Tympan/Tympan_Rev_D_Hardware/README.md

# Tympan Rev D Hardware
Repository for Tympan Rev D electronics and case designs

## Features

* Based on Teensy 3.6
* TLV320AIC3206 CODEC
* On board MEMS Microphone SPM0687LR5H-1
* BC127 Bluetooth module with audio support
* LiPo Battery Charge Circuit
* CODEC Line In/Out breakout
* UART breakout
* I2C breakout
* SPI breakout
* I2S breakout
* Teensy RTC battery breakout

### Tympan Rev D breakout pins compatible with Tympan AIC Codec Shield. Add 2 more channels to your Tympan!
