Tympan/Tympan_Rev_D_Hardware/Production/Tympan_D_BOM.xlsx

Item | Reference | Package | Quantity | Value | Manufacturer | Part Number | Notes
1 | BT1 | 4UCON-0217-20519 | 1 | 4UCON-20519 | 4UCON | 20519 | Consigned by Solutions
2 | C1,C3,C5,C7,C10,C14,C16,C18,C28,C29,C42 | C_0402 | 11 | 0.1uF | TDK Corporation | C1005X7R1H104K050BB
3 | C2,C8,C12,C13,C23,C24,C25,C26,C27,C32,C33,C37,C39 | C_0402 | 13 | 2.2uF | Murata | GRT155C71A225KE13D
4 | C30,C31 | C_0402 | 2 | 10nF | Yageo | AC0402KPX7R9BB103
5 | C35 | C_0402 | 1 | 4.7uF | TDK Corporation | C1005X5R1A475K050BC
6 | C4,C6,C11,C15 | C_0402 | 4 | 10uF | Murata | GRM155C80J106ME11J
7 | C40 | C_0402 | 1 | 15pF | Wurth | 885012005008
8 | C41 | C_0402 | 1 | 22nF | Wurth | 885012205014
9 | C9,C17,C19,C20,C21,C22,C34 | C_0402 | 7 | 1uF | Murata | GRM155C81C105KE15D
10 | CONN1 | MOLEX_47571-0001 | 1 | 8_PIN_microSD | Molex | 47571-0001
11 | D1 | ABHB1608S | 1 | 2 color LED | Everlight | 18-225SURSYGC/S530-A4/E4/TR8
12 | D2 | C_1206 | 1 | LED Red | Lite-On | LTST-C150EKT
13 | D3 | C_1206 | 1 | LED Amber | Lite-On | LTST-C150AKT
14 | D4,D5 | ACDBA340-HF | 2 | Shottkey | Comchip | ACDBA340-HF
15 | D6 | CLMVB-FKA-CFHEHLCBB7a363 | 1 | Led_RGB_CA | Cree | CLMVB-FKA-CFHEHLCBB7a363
16 | F1 | C_1206 | 1 | FUSE | Bell Fuse | C1Q 1
17 | IC1 | BGA-144-1mm | 1 | ARM | NXP | MK66FX1M0VMD18
18 | IC2 | QFN-16-1EP_3x3mm_Pitch0.5mm | 1 | MKL02Z32VFG4 | PJRC | IC_MKL02Z32_QFN16 | Consigned by Solutions
19 | IC3 | BC127 | 1 | BC127 | Sierra Wireless | BC127-1103383
20 | J1 | SJ-3523-SMT-TR | 1 | Phone Out | CUI Inc | SJ-3523-SMT-TR
21 | J2 | SJ-3524-SMT-TR | 1 | Mic In | CUI Inc | SJ-3524-SMT-TR-PI
22 | L1,L2 | C_0402 | 2 | 600R | TDK Corporation | MMZ1005S601HT000
23 | L3 | C_0603 | 1 | 1K | Murata | BLM18KG102SH1D
24 | MIC2,MIC1 | SPM0687LR5H-1 | 2 | MEMS Microphone | Knowles | SPM0687LR5H-1
25 | P1 | 10118193_microUSB | 1 | USB_OTG | Amphenol | 10118193-0001LF
26 | P3,P4,P5,P2 | Pin_Header_Straight_1x06_Pitch2.54mm | 4 | CONN_01X06 | Samtec | SSW-106-01-G-S
27 | P6 | Pin_Header_Straight_1x03_Pitch2.00mm | 1 | DNP | DNP | DNP | DNP
28 | R12,R13 | C_0603 | 2 | 0R | Vishay Dale | CRCW06030000Z0EA
29 | R14,R17 | C_0603 | 2 | DNP | DNP | DNP | DNP
30 | R15,R16 | C_0603 | 2 | 2.2K | Yageo | RC0603FR-072K2L
31 | R18,R21 | R_0402 | 2 | 240R | Yageo | RC0402JR-07240RL
32 | R19,R20,R32,R33,R1,R11 | R_0402 | 6 | 1K | Vishay Dale | CRCW04021K00FKED
33 | R23 | R_0402 | 1 | 100K | Vishay Dale | CRCW0402100KFKED
34 | R25,R34,R35,R36 | R_0402 | 4 | 470R | Yageo | RC0402FR-07470RL
35 | R30,R31 | R_0402 | 2 | 10K | Yageo | RC0402FR-0710KL
36 | R6,R2,R3,R4,R5,R7,R9,R10,R26,R27 | R_0402 | 10 | 33R | Yageo | RC0402FR-0733RL
37 | R8 | R_0402 | 1 | 2.2K | Yageo | RC0402JR-0722KL
38 | RV1 | Pin_Header_Straight_1x03_Pitch2.54mm | 1 | POT | Bourns | 3352T-1-103L
39 | SW1 | CL-SB-22A | 1 | Slide Switch | Nidec Copal | CL-SB-22A-11T
40 | SW2 | PTS810 | 1 | TACT_SWITCH | C&K | PTS810 SJK 250 SMTR LFS
41 | U1 | SOT-23-5 | 1 | 3V3 Regulator | Diodes Inc | AP2210K-3.3TRG1
42 | U2 | UQFN-40-1EP_5x5mm_Pitch0.4mm | 1 | CODEC | Texas Instrument | TLV320AIC3206IRSBT
43 | U3 | SOT-353_SC-70-5 | 1 | Analog Switch IC | Texas Instrument | TS5A3166DCKR
44 | U4 | SOT-23-5 | 1 | 1V8 Regulator | Texas Instrument | LP5907MFX-1.8/NOPB
45 | U5 | SOT-23-5 | 1 | LiPo Charge IC | Microchip | MCP73831T-2DCI/OT
46 | Y1 | LFXTAL009678 | 1 | 32.768kHz | IQD | LFXTAL009678Reel
47 | Y2 | FA_238_16.0000MB_K3 | 1 | 16MHz | Epson | FA_238_16.0000MB_K3
