Tympan/Tympan_Rev_D_Hardware/Enclosure/Enclosure_01/Tympan D Enclosure Assembly.SLDASM

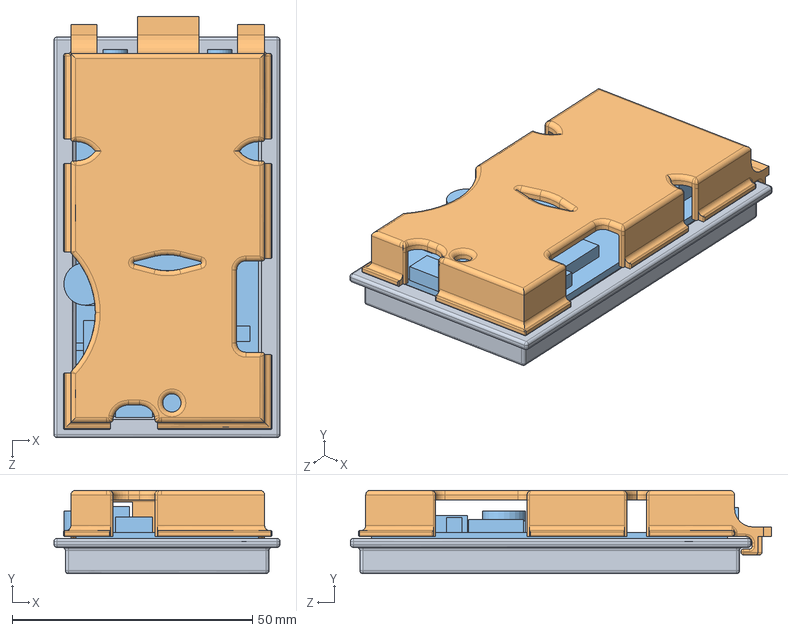
[picture p1: CAD file, 2018-05-24]
Enclosure/Enclosure_01/Tympan D Enclosure Assembly.SLDASM
47.0 x 17.4 x 87.7 mm
Joel Enclosure Bottom
Joel Enclosure Top
Chip's Chip
