Tympan/Tympan_Rev_D_Hardware/Enclosure/Enclosure_01/Tympan D Enclosure Bottom.STEP

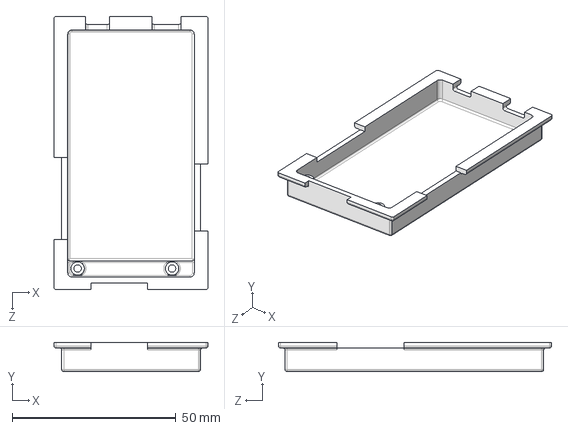
[picture p2: CAD file, 2018-05-30]
Enclosure/Enclosure_01/Tympan D Enclosure Bottom.STEP
47.0 x 8.89 x 83.4 mm
