Tympan/Tympan_Rev_D_Hardware/Enclosure/Enclosure_02/Tympan RevD Case Bottom.stl

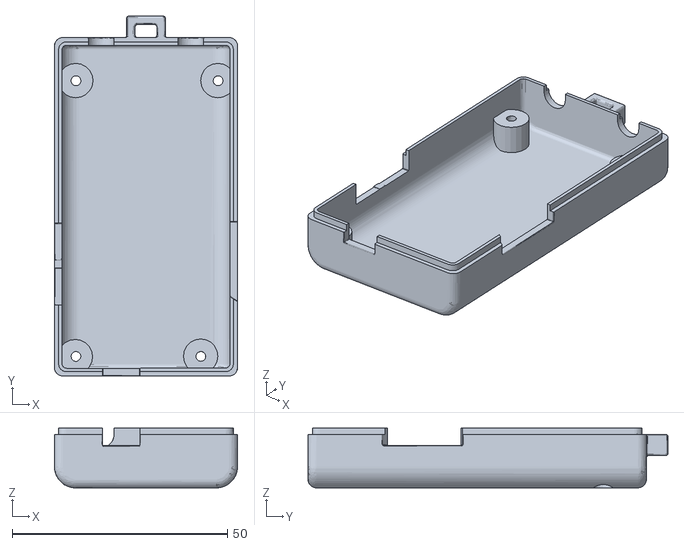
[picture p3: CAD file, 2020-02-06]
Enclosure/Enclosure_02/Tympan RevD Case Bottom.stl
42.6 x 83.6 x 13.9
