Tympan/Tympan_Rev_D_Hardware/Enclosure/PCB ASSY/PCB as ASSY/LED_SMT_GENERIC_FAKE CAD.SLDPRT

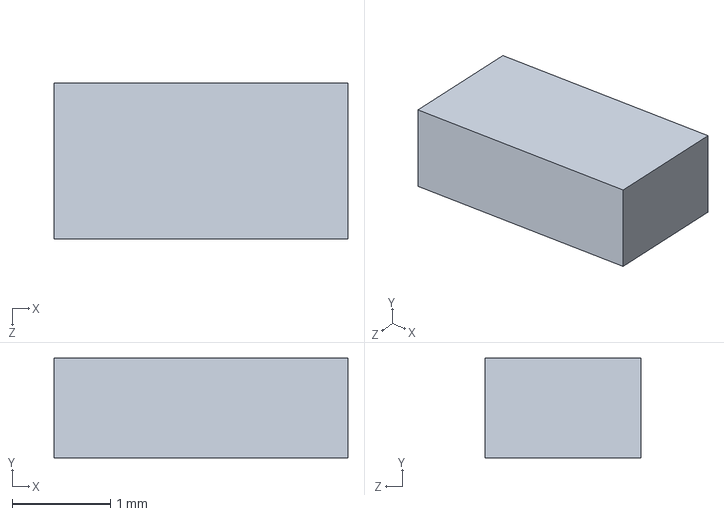
[picture p4: CAD file, 2020-01-31]
Enclosure/PCB ASSY/PCB as ASSY/LED_SMT_GENERIC_FAKE CAD.SLDPRT
3.00 x 1.02 x 1.59 mm
