Tympan/Tympan_Rev_D_Hardware/Enclosure/Enclosure_01/Tympan D Enclosure Top.STEP

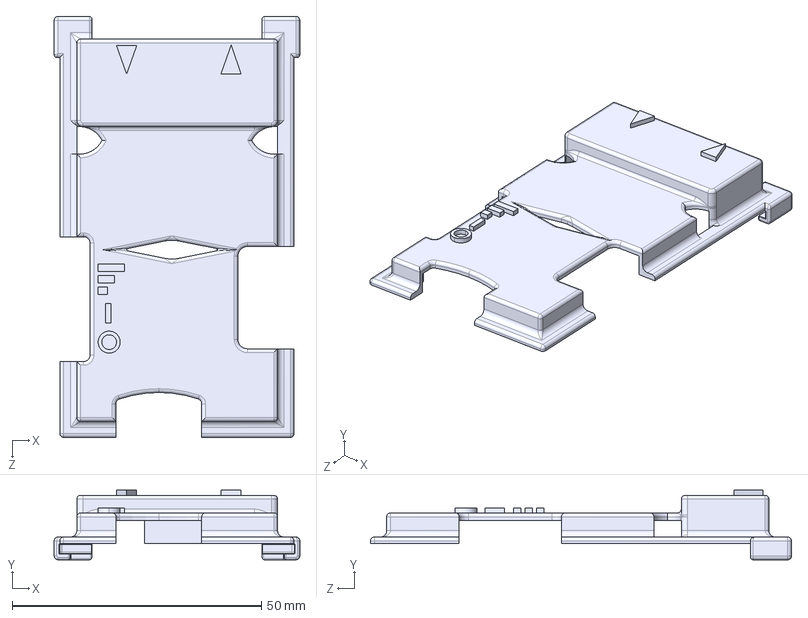
[picture p5: CAD file, 2018-05-30]
Enclosure/Enclosure_01/Tympan D Enclosure Top.STEP
49.3 x 14.0 x 84.5 mm
