Tympan/Tympan_Rev_D_Hardware/Enclosure/Enclosure_02/Tympan RevD Case Top.stl

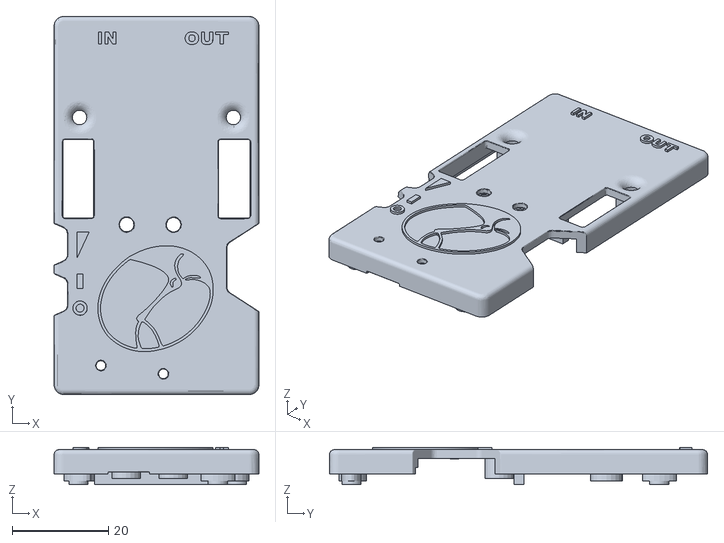
[picture p6: CAD file, 2020-02-06]
Enclosure/Enclosure_02/Tympan RevD Case Top.stl
42.6 x 78.6 x 7.80
