Tympan/Tympan_Rev_D_Hardware/Enclosure/PCB ASSY/PCB as ASSY/HEADER_SOCKET_6POS_MOLEX_901471106.SLDPRT

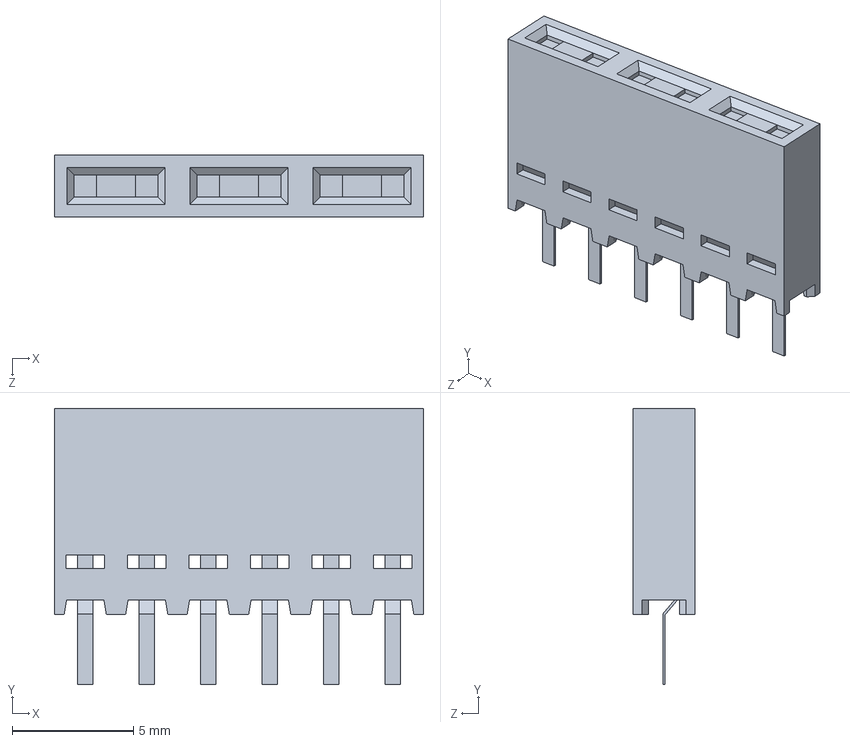
[picture p7: CAD file, 2020-01-31]
Enclosure/PCB ASSY/PCB as ASSY/HEADER_SOCKET_6POS_MOLEX_901471106.SLDPRT
15.2 x 11.4 x 2.54 mm
