Tympan/Tympan_Rev_D_Hardware/Enclosure/PCB ASSY/PCB as ASSY/SD CARD HOLDER_MOLEX_475710001.SLDPRT

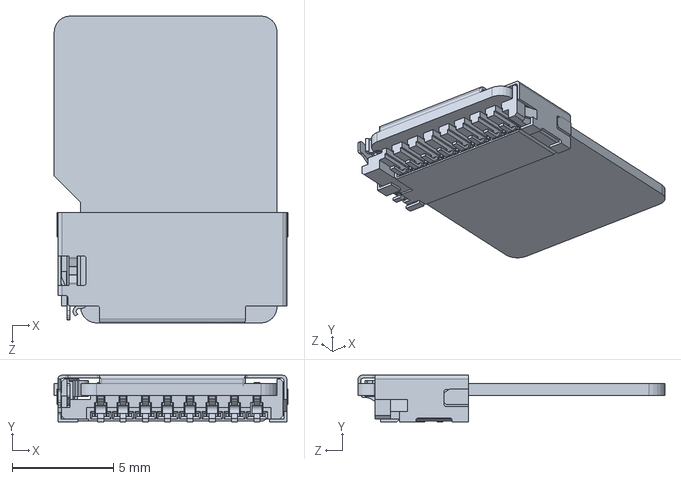
[picture p8: CAD file, 2020-01-31]
Enclosure/PCB ASSY/PCB as ASSY/SD CARD HOLDER_MOLEX_475710001.SLDPRT
11.5 x 2.30 x 15.2 mm
