Tympan/Tympan_Rev_D_Hardware/Enclosure/PCB ASSY/PCB as ASSY/TACTILE SW_PTS810_CREARE_MOCKUP.SLDPRT

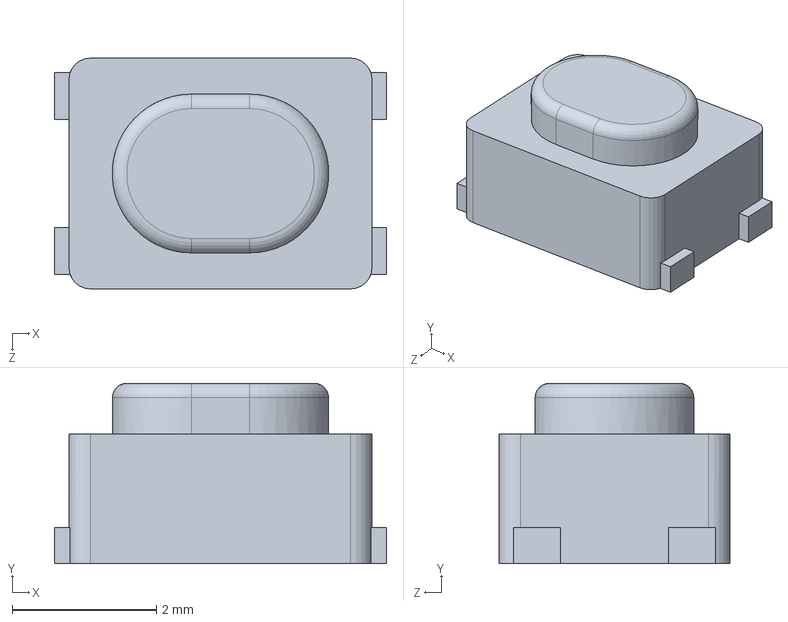
[picture p9: CAD file, 2020-01-31]
Enclosure/PCB ASSY/PCB as ASSY/TACTILE SW_PTS810_CREARE_MOCKUP.SLDPRT
4.60 x 2.50 x 3.20 mm
