Tympan/Tympan_Rev_D_Hardware/Enclosure/PCB ASSY/PCB as ASSY/CUI_DEVICES_SJ-3524-SMT-TR-PI.sldprt

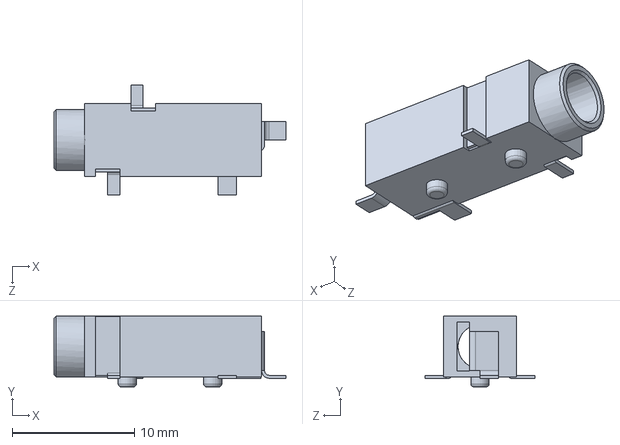
[picture p10: CAD file, 2020-01-31]
Enclosure/PCB ASSY/PCB as ASSY/CUI_DEVICES_SJ-3524-SMT-TR-PI.sldprt
19.0 x 5.80 x 9.00 mm
