Tympan/Tympan_Rev_D_Hardware/Enclosure/PCB ASSY/PCB as ASSY/SWITCH_CL_SB-22A-11T.SLDPRT

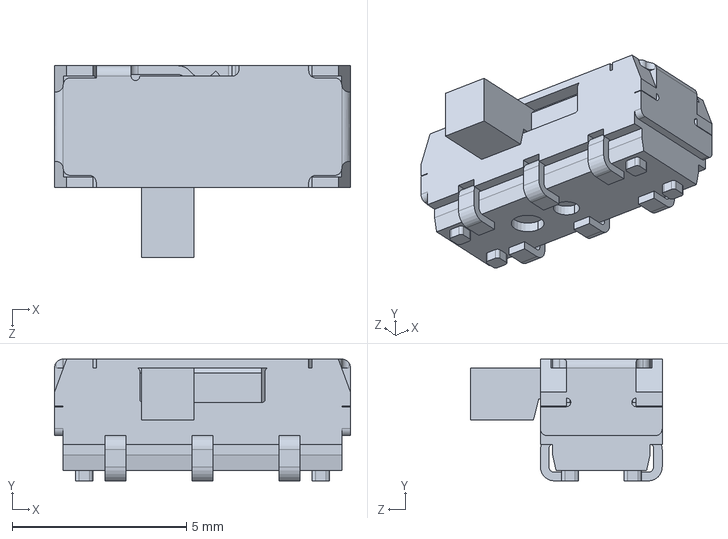
[picture p11: CAD file, 2020-01-31]
Enclosure/PCB ASSY/PCB as ASSY/SWITCH_CL_SB-22A-11T.SLDPRT
8.50 x 3.50 x 5.50 mm
