Tympan/Tympan_Rev_D_Hardware/Enclosure/PCB ASSY/PCB as ASSY/BT_MODULE_SIERRA_BC127v4x_3.SLDPRT

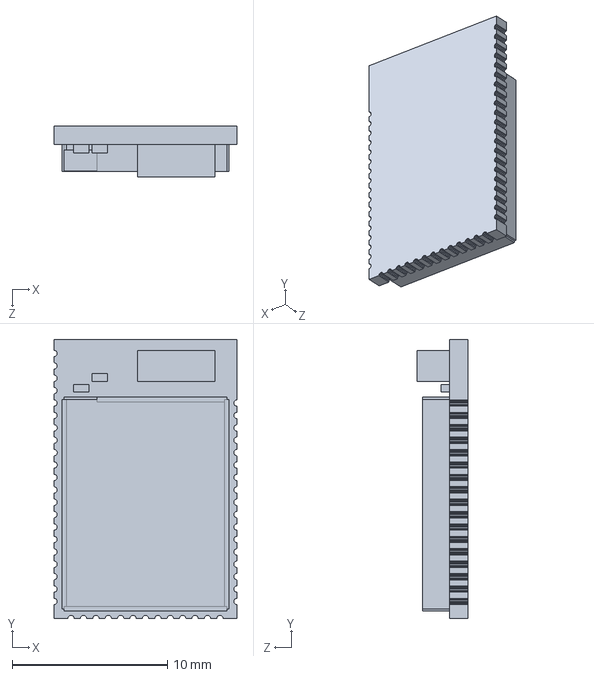
[picture p12: CAD file, 2020-01-31]
Enclosure/PCB ASSY/PCB as ASSY/BT_MODULE_SIERRA_BC127v4x_3.SLDPRT
11.8 x 18.0 x 3.30 mm
