Tympan/Tympan_Rev_D_Hardware/Enclosure/PCB ASSY/PCB as ASSY/LED_3COLOR_CREE_CLMVB-FKA-CFHEHLCBB7A363.SLDPRT

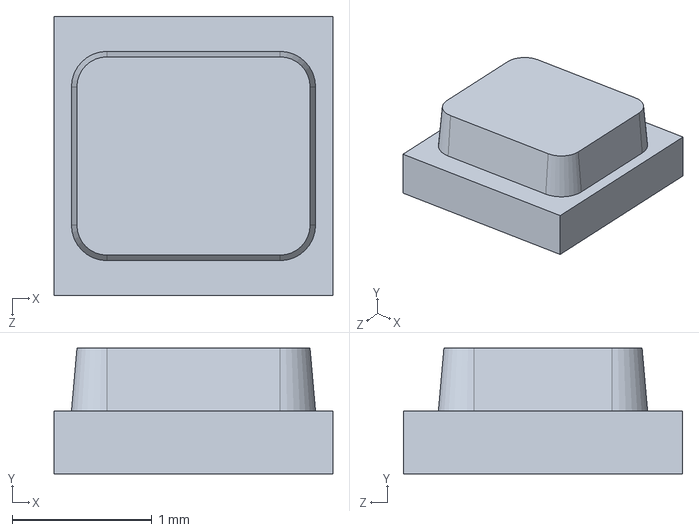
[picture p13: CAD file, 2020-01-31]
Enclosure/PCB ASSY/PCB as ASSY/LED_3COLOR_CREE_CLMVB-FKA-CFHEHLCBB7A363.SLDPRT
2.00 x 0.9 x 2.00 mm
