Tympan/Tympan_Rev_D_Hardware/Enclosure/PCB ASSY/PCB as ASSY/USB-A_MICRO_10118193-0001lFC.SLDPRT

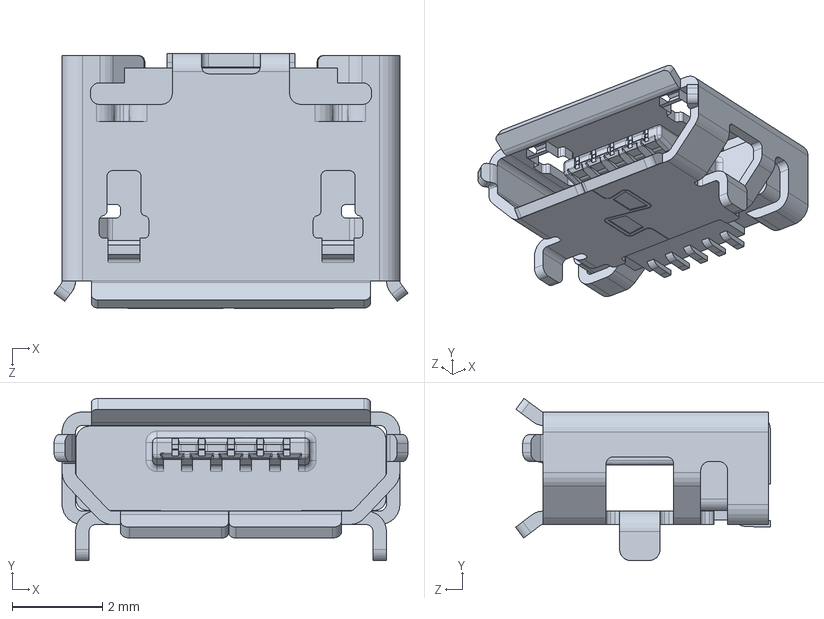
[picture p14: CAD file, 2020-01-31]
Enclosure/PCB ASSY/PCB as ASSY/USB-A_MICRO_10118193-0001lFC.SLDPRT
7.86 x 3.60 x 5.66 mm
