Tympan/Tympan_Rev_D_Hardware/Enclosure/PCB ASSY/PCB as ASSY/CUI_DEVICES_SJ-3523-SMT-TR.sldprt

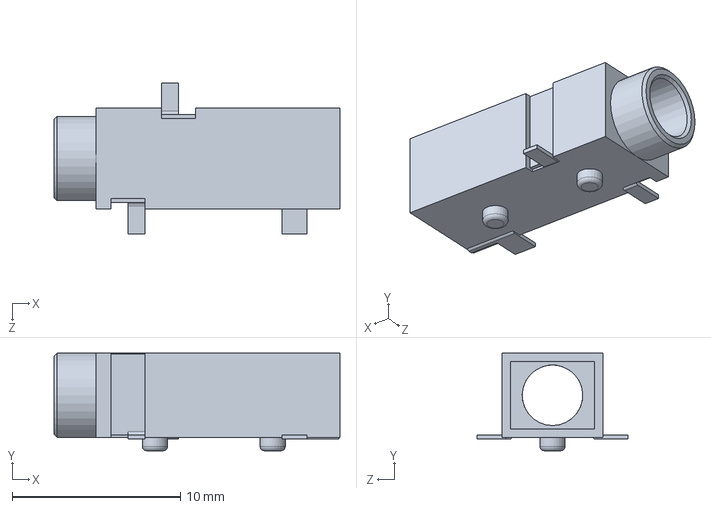
[picture p15: CAD file, 2020-01-31]
Enclosure/PCB ASSY/PCB as ASSY/CUI_DEVICES_SJ-3523-SMT-TR.sldprt
17.0 x 5.80 x 9.00 mm
