Tympan/Tympan_Rev_D_Hardware/Enclosure/PCB ASSY/PCB as ASSY/POTENTIOMETER_BOURNES_3352T-1-103LF.SLDPRT

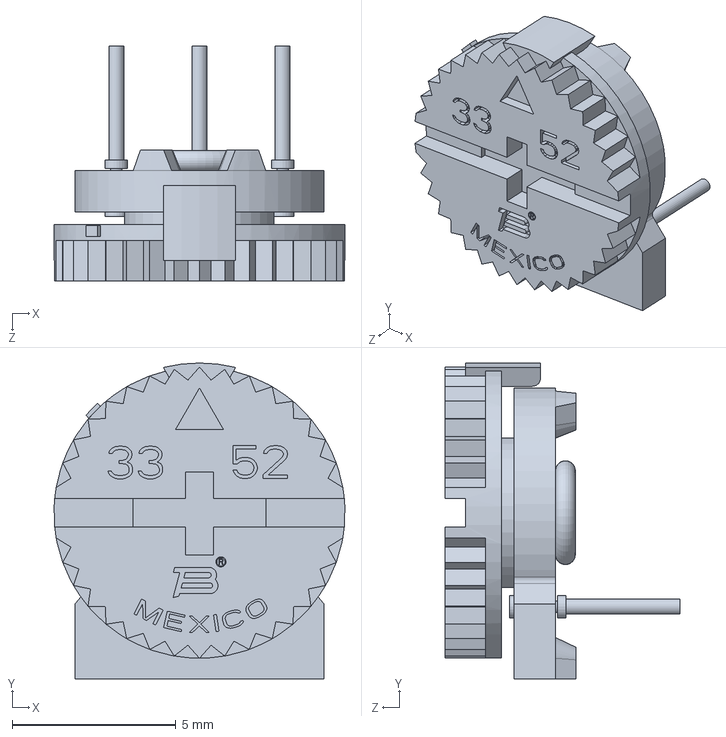
[picture p16: CAD file, 2020-01-31]
Enclosure/PCB ASSY/PCB as ASSY/POTENTIOMETER_BOURNES_3352T-1-103LF.SLDPRT
8.88 x 9.65 x 7.19 mm
