Tympan/Tympan_Rev_D_Hardware/Enclosure/PCB ASSY/20200131_TYMPAN_PCB_ASSY___SINGLE_PART.SLDPRT

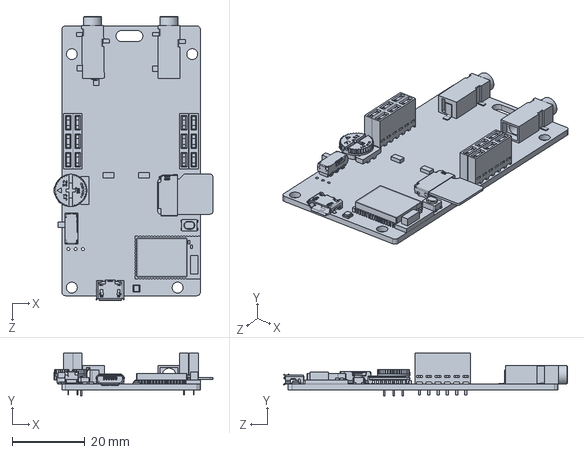
[picture p17: CAD file, 2020-01-31]
Enclosure/PCB ASSY/20200131_TYMPAN_PCB_ASSY___SINGLE_PART.SLDPRT
43.6 x 11.7 x 78.0 mm
