Tympan/Tympan_Rev_D_Hardware/Enclosure/PCB ASSY/PCB as ASSY/20200131_TYMPAN_REV-D_PCB_ASSY.SLDASM

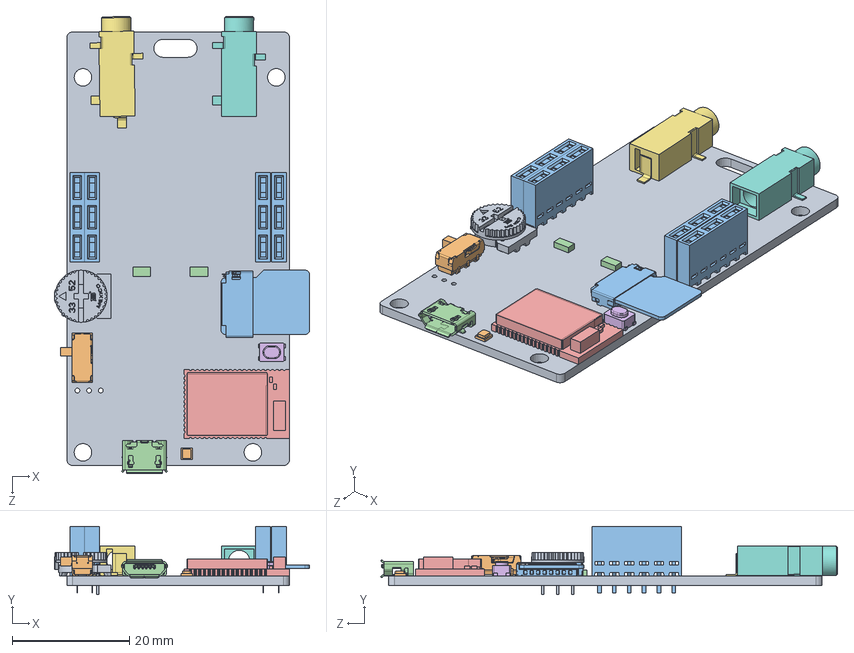
[picture p18: CAD file, 2020-01-31]
Enclosure/PCB ASSY/PCB as ASSY/20200131_TYMPAN_REV-D_PCB_ASSY.SLDASM
43.6 x 11.7 x 78.0 mm
20200131_TYMPAN_REV-D_PCB
SWITCH_CL_SB-22A-11T
SD CARD HOLDER_MOLEX_475710001
USB-A_MICRO_10118193-0001lFC
BT_MODULE_SIERRA_BC127v4x_3
TACTILE SW_PTS810_CREARE_MOCKUP
CUI_DEVICES_SJ-3524-SMT-TR-PI
CUI_DEVICES_SJ-3523-SMT-TR
POTENTIOMETER_BOURNES_3352T-1-103LF
LED_3COLOR_CREE_CLMVB-FKA-CFHEHLCBB7A363
HEADER_SOCKET_6POS_MOLEX_901471106 x 4
LED_SMT_GENERIC_FAKE CAD x 2
