Tympan/Tympan_Rev_D_Hardware/(list of files, cad)

Other CAD files:
Enclosure/Enclosure_01/Tympan D Enclosure Bottom.SLDPRT
Enclosure/Enclosure_01/Tympan D Enclosure Bottom.STL
Enclosure/Enclosure_01/Tympan D Enclosure Top.SLDPRT
Enclosure/Enclosure_01/Tympan D Enclosure Top.STL
