Tympan/Tympan_Rev_D_Hardware/(threads)

Thread 1 (2019-08-08):

Teensy 4 for Tympan E?

shapr, 2019-08-08:
I suspect it would take a long time to update the Tympan, but the Teensy 4 is out, and much more powerful:
https://hackaday.com/2019/08/07/new-teensy-4-0-blows-away-benchmarks-implements-self-recovery-returns-to-smaller-form/

biomurph, 2019-08-08:
Yes, I saw that and I have 2 on order.

We have the Tympan C which is actually a shield  for the Teensy 3.6, so
lashing that to the Teensy 4 would be the best development path.

-- Joel

Any noise in the prior signal has been inserted by my mobile device

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

Thread 2 (2019-12-02):

Intermittent power up fail on the BC127

biomurph, 2019-12-02:
Every so often at start up the BC127 LEDs don't flash, indicating that it has not booted up correctly. Since this is intermittent, it seems to be a result of the power supply. There is a related issue [here](https://forum.pjrc.com/threads/31688-chip-won-t-power-on-unless-I-wait-since-last-power-on). The recommendation from the BC127 datasheet is on page 26 of [this document](https://media.digikey.com/pdf/Data%20Sheets/Sierra%20Wireless%20PDFs/BC127_-HD_-EXT_TechSpec_4-9-17.pdf).

There's room on the board to add the RC circuit in the next hardware revision.

Thread 4 (2020-12-10):

RevD: Silkscreen on battery jack is wrong

chipaudette, 2020-12-10:
I noticed this a long time ago, but I don't know if we ever addressed it...

On RevD, the silkscreen for the battery jack is wrong...it shows the + and - going to the wrong traces.

When you plug in an Adafruit battery, you can totally see that the red wire goes to the trace marked with a minus and you can see that the black wire goes to the trace marked with a plus.  Oops!

@biomurph, Since we can't change the as-built RevD boards, can you at least put a note on the schematic that the silkscreen is wrong?

biomurph, 2020-12-10:
That was such an unfortunate mistake.

- changed pcb silkscreen to correct orientation
- added note to schematics
- updated pdf of schematics

Closed 2020-12-10.

Thread 5 (2021-01-22):

DAT/CLK Labels for PDM Digital Mic Switched

eyuan-creare, 2021-01-22:
The labels for the PDM mic (Data and Clock) are flipped on the Tympan Rev-D schematic.

Here is what the AIC datasheet shows:

From the AIC Datasheet
-	PDM Data is on SCLK/MFP3
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

 -	PDM Clock is on MISO/MFP4
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

And here is what the Tympan Rev-D schematic shows:

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

To correct this, the board labels for the 6-pin header (P2) need flipped as well:

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

This was confirmed experimentally, but it would be good to double check the gerber traces to confirm this.

biomurph, 2021-01-23:
This can be fixed easily by swapping the net names, and any attending silk markings.

biomurph, 2021-01-23:
Pushed changes to solve this issue.

eyuan-creare, 2021-01-23:
Thanks Joel! That was fast!

eyuan-creare, 2021-01-23:
@biomurph Should we rev the pdf schematic and note the change on it? Or wait until a new board is printed?

biomurph, 2021-01-23:
@eyuan-creare good thinking!
Just put a note on the schematics and updated the PDF

Closed 2021-01-23.

Thread 6 (2021-06-01):

Alter audio-attenuating resistors around the Bluetooth module (R32 and R33)

chipaudette, 2021-06-01:
See this post in the forum: https://forum.tympan.org/t/issues-with-external-mic-in-line-in-1/299

This person is correct that the 1K-to-ground resistors (R32 and R33) are too small to support a line input.

*Solution Idea 1 (FAIL):*  Ideally, for a line-level input, the resistors to ground would be at least 10K.  Is that acceptable for these resistors? What is their function?  Their function is to form a voltage divider to reduce the signal strength from the Bluetooth module before it goes to the audio codec.  Right now, we have a 10x divider.  If we were to keep the 10x divider, we'd have to increase the series resistors (R30 and R31) to 100K.  But these high values would interfere with the audio codec's ~20K input impedance and would knock down the signal too much.

*Solution Idea 2 (SUCCEED?):*  Now that we have lived with the system, I do not believe that we need a 10x divider.  I think that, worst case, the BT module puts out 0->3.3V whereas the audio codec can only take 0->1.8V.  Therefore, we only need a ~2x voltage divider.  Therefore, we can change R32 and R33 to 10K and leave R30 and R31 at their current value of 10K.

@biomurph, if we do a revision to RevD, can we change these two resistors to the higher value?

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

biomurph, 2021-06-01:
Interesting idea @chipaudette
Is it possible for you to test this change? Or is it pretty obvious?

If it's obvious, and a high level of confidence that it will work, I can change the value of the R32 and R33, but it would have to get confirmed very soon as we are in production for the Rev E, which uses this same topology.

chipaudette, 2021-06-04:
It is high confidence.  If it can be done on RevE, that would be great.  If not, we'll live.

biomurph, 2021-06-04:
OK, I have a request in with my CM. I don't think it's too late to make the change.
Will update here and in the schematic if it's possible.
