Tympan/Tympan_Rev_D_Hardware/Tympan RevD Schematic.pdf

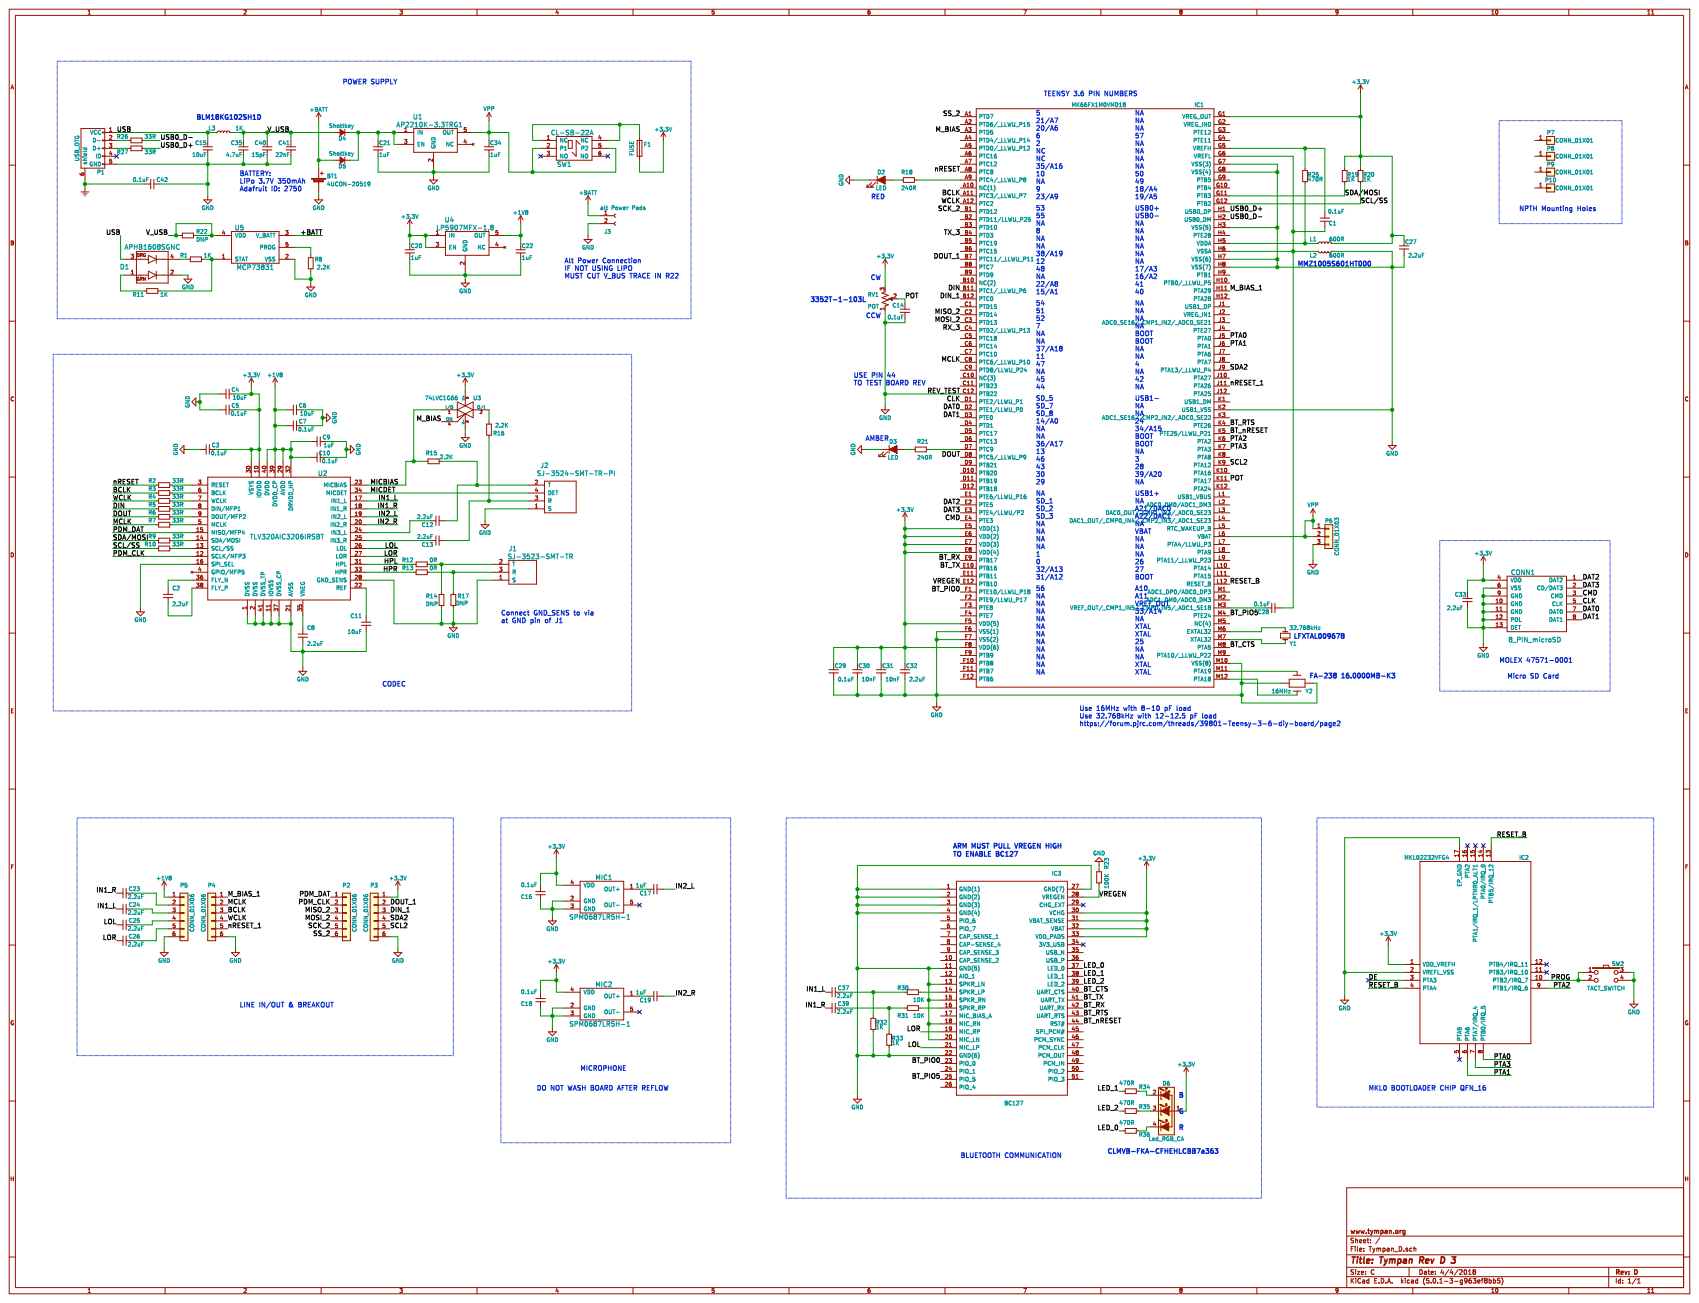
[picture p19: page 1]
