Tympan/Tympan_Rev_D_Hardware/TympanRevDschem.pdf

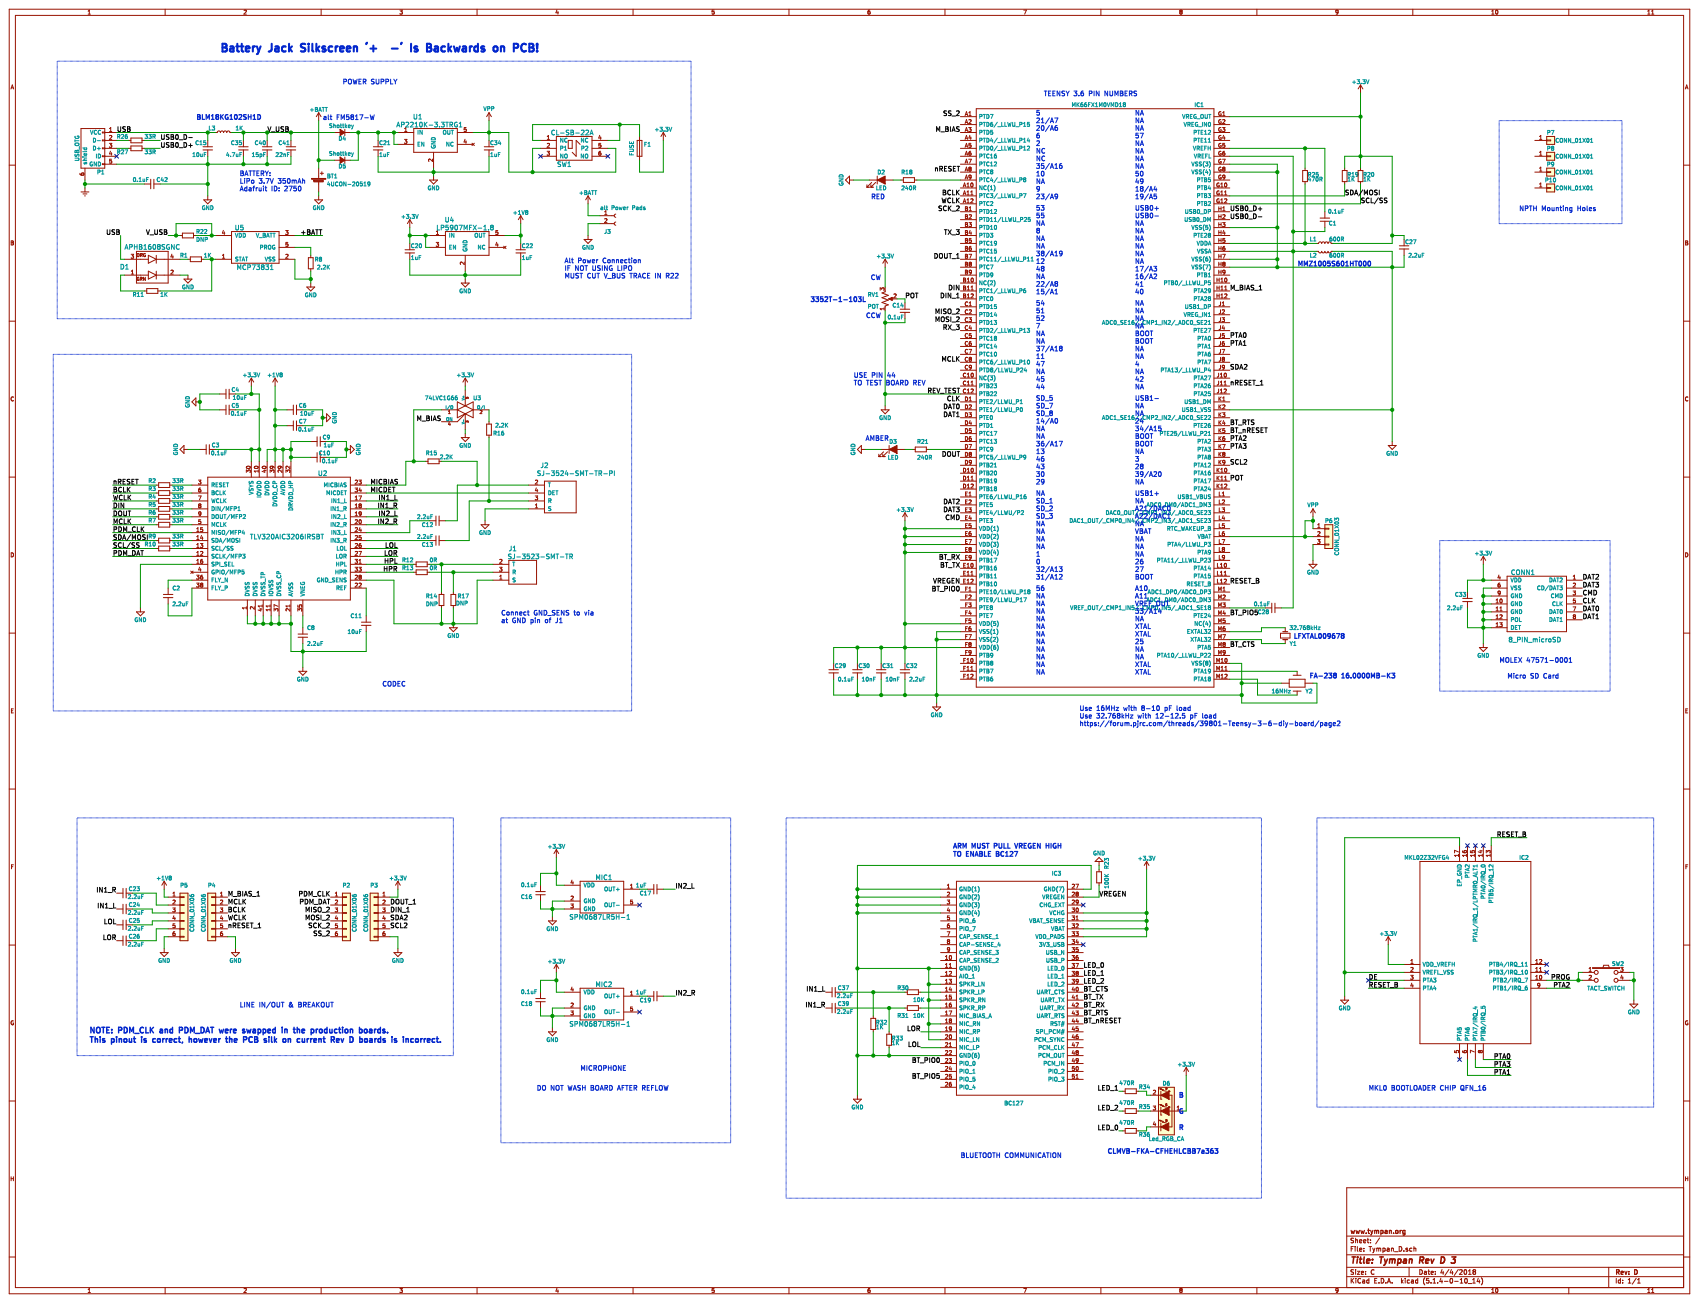
[picture p20: page 1]
