Tympan/Tympan_Rev_D_Hardware/(commit log)

2018-05-30 Added STEP files
    [Joel Enclosure Bottom.STEP, Joel Enclosure Top.STEP]
2018-05-30 Renamed files for consistency
    [Tympan D Enclosure Bottom.STEP, Tympan D Enclosure Bottom.STL, Tympan D Enclosure Top.STEP, Tympan D Enclosure Top.STL]
2019-01-12 Updated with latest version of the hardware
    [Tympan_D-B.Cu.gbr, Tympan_D-B.Mask.gbr, Tympan_D-B.Paste.gbr, Tympan_D-B.SilkS.gbr, Tympan_D-Edge.Cuts.gbr, Tympan_D-F.Cu.gbr, Tympan_D-F.Mask.gbr, Tympan_D-F.Paste.gbr]
2019-03-01 Adjusted tracks. Switched PIO0
    Moved PIO0 to a digital pin
    Moved tracks from under the xtal per PJRC
    Cleaned up speaker out ground trace
    [Tympan_D.kicad_pcb, Tympan_D.sch]
2019-03-06 Updated changes from client
    [Tympan_D.kicad_pcb, Tympan_D.sch]
2019-03-06 Update to readme
    [Tympan_D-B.Cu.gbr, Tympan_D-B.Mask.gbr, Tympan_D-B.Paste.gbr, Tympan_D-B.SilkS.gbr, Tympan_D-Edge.Cuts.gbr, Tympan_D-F.Cu.gbr, Tympan_D-F.Mask.gbr, Tympan_D-F.Paste.gbr]
2019-03-06 updated schematic pdf
2019-03-15 fixed broken symbols
    [Tympan_D.sch]
2019-03-16 Final changes to PCB
    [Tympan_D.kicad_pcb, Tympan_D.sch]
2019-03-16 Moved breadout schematics for clarity
    [Tympan_D.sch]
2019-03-18 Made Production Files
    [Tympan_D-B.Cu.gbr, Tympan_D-B.Mask.gbr, Tympan_D-B.Paste.gbr, Tympan_D-B.SilkS.gbr, Tympan_D-Edge.Cuts.gbr, Tympan_D-F.Cu.gbr, Tympan_D-F.Mask.gbr, Tympan_D-F.Paste.gbr]
2019-03-19 updated schematics
    [Tympan_D-B.Cu.gbr, Tympan_D-B.Mask.gbr, Tympan_D-B.Paste.gbr, Tympan_D-B.SilkS.gbr, Tympan_D-Edge.Cuts.gbr, Tympan_D-F.Cu.gbr, Tympan_D-F.Mask.gbr, Tympan_D-F.Paste.gbr]
2019-03-26 added some more dimensions
    [Tympan_D.kicad_pcb]
2019-04-02 tightened solder mask around pads per CM recommendation
    [Tympan_D.kicad_pcb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]
2019-04-15 Renamed schematic PDF
2020-01-31 Added CAD for PCB ASSY
    Added CAD as assembly, single part (exterior faces), or STEP
    [20200131_TYMPAN_PCB_ASSY___SINGLE_PART.SLDPRT, 20200131_TYMPAN_REV-D_PCB_ASSY.SLDASM, BT_MODULE_SIERRA_BC127v4x_3.SLDPRT, CUI_DEVICES_SJ-3523-SMT-TR.sldprt, CUI_DEVICES_SJ-3524-SMT-TR-PI.sldprt, HEADER_SOCKET_6POS_MOLEX_901471106.SLDPRT, LED_3COLOR_CREE_CLMVB-FKA-CFHEHLCBB7A363.SLDPRT, LED_SMT_GENERIC_FAKE CAD.SLDPRT]
2020-02-06 finally added current production STL files
    [Tympan RevD Case Bottom.stl, Tympan RevD Case Top.stl]
2020-04-03 added some of the 3d files to the model for rendering and export
    [Tympan_D.kicad_pcb]
2020-12-10 switched '+ -' label for battery connect to correct it
    [Tympan_D.kicad_pcb]
2020-12-10 Noted Jack Mistake on schematics & updated pdf
2021-01-23 Changed the PDM pins
    Also added Melody User Guides for reference
    [Tympan_D.kicad_pcb, Tympan_D.sch]
2021-01-23 Updated Schematic PDF with note about PDM pin swap
    [Tympan_D.sch]
